fan4tix/IV-25-VFD-Display/images/display1.jpg

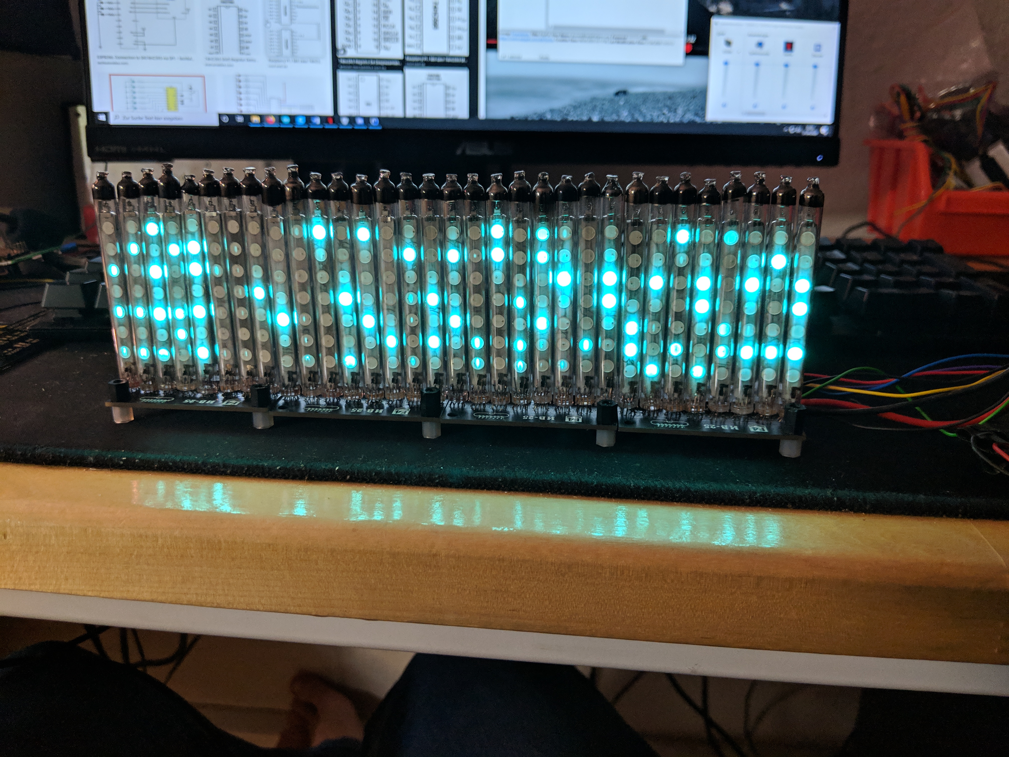
images/display1.jpg
