fan4tix/IV-25-VFD-Display/images/display3.jpg

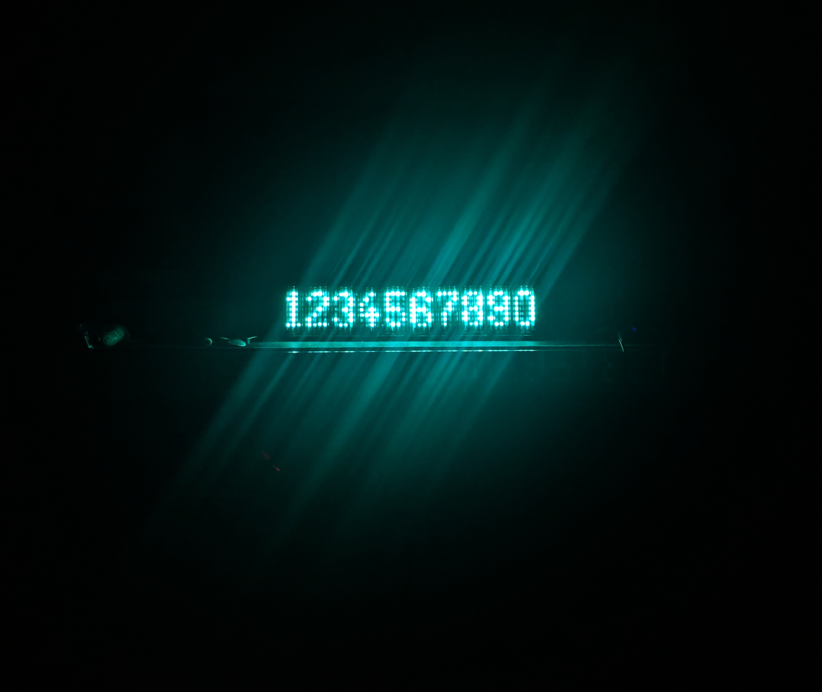
images/display3.jpg
