fan4tix/IV-25-VFD-Display/images/display4.jpg

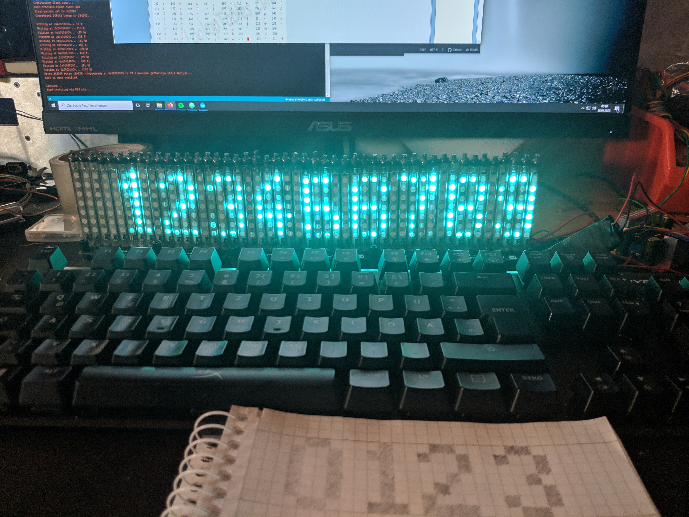
images/display4.jpg
