fan4tix/IV-25-VFD-Display/pcbs/Schematic_IV-25 Controller_2021-01-01.pdf

# GND 15 IO15 16 IO2 17 IO0 18 IO4 19 IO5 20 RXD 21 TXD 22

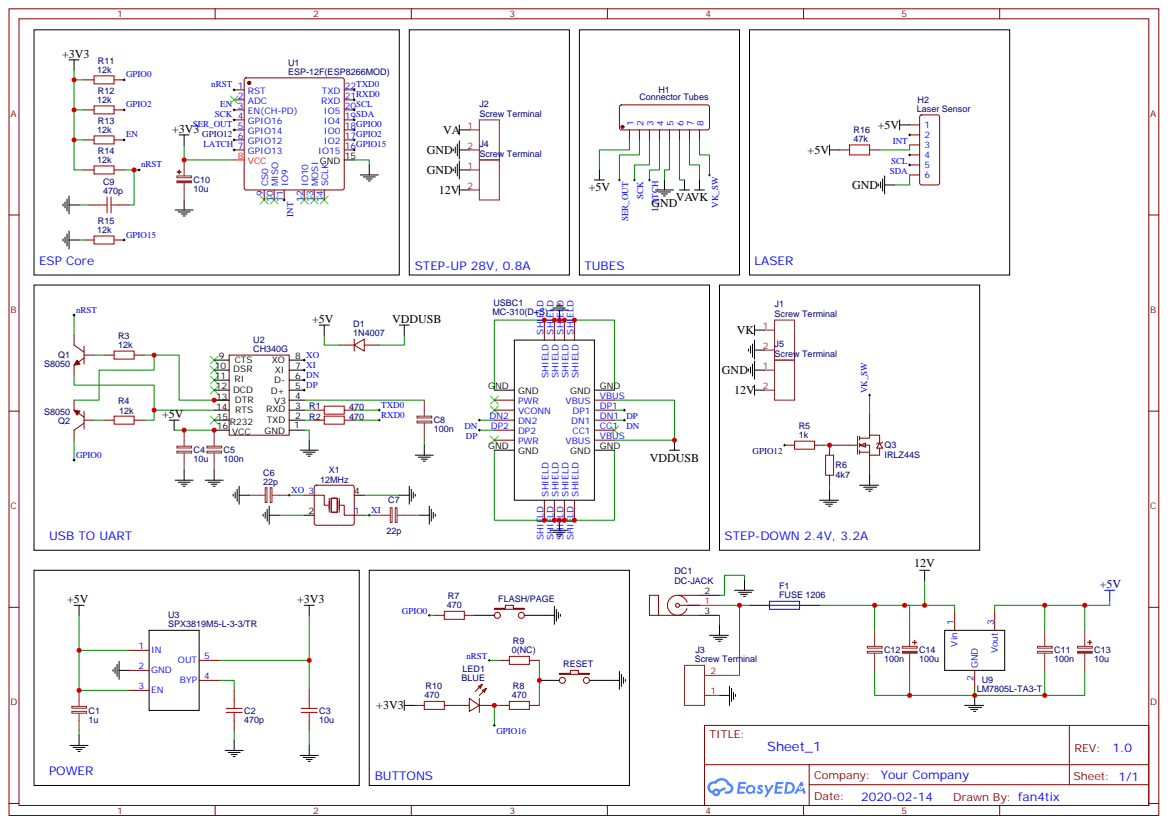
[picture p8: page 1]

SHIELD SHIELD SHIELD SHIELD SHIELD

GND GND VBUS VBUS CC1 CC1 DN1 DN1 DP1 DP1 VBUS VBUS GND GND GND GND
PWR
VCONN
GND
