fan4tix/IV-25-VFD-Display/pcbs/Schematic_IV-25 Dispaly_2021-01-01.pdf

A | A

1

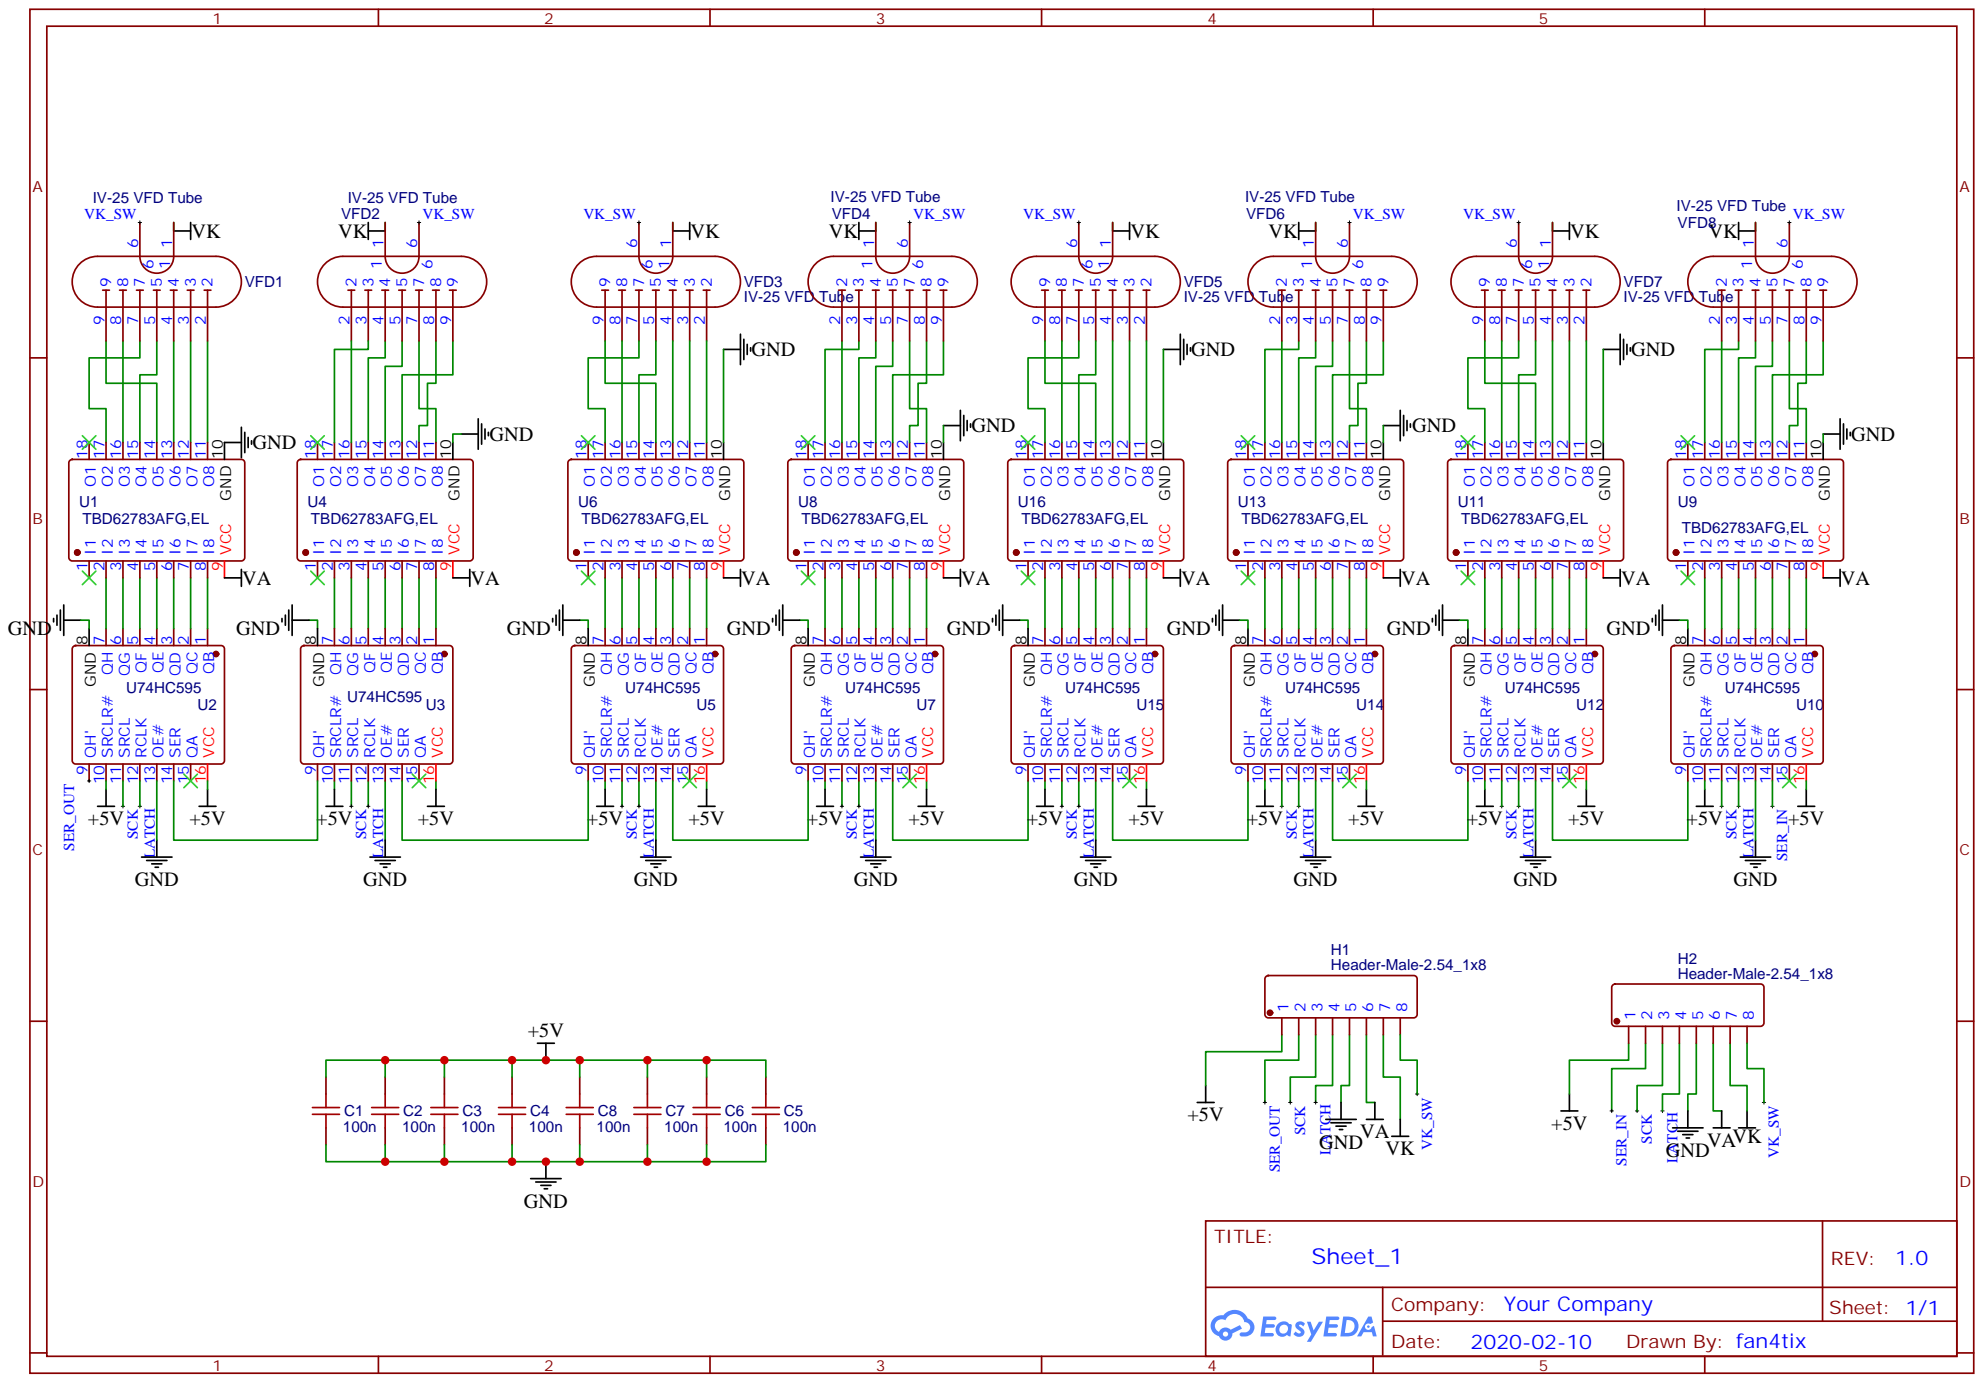
[picture p9: page 1]
