fan4tix/IV-25-VFD-Display/code/IV-25_Display/iv25_font.h

#ifndef _font_h_
#define _font_h_

const uint16_t font_offset[] = {
    0,
    0,
    0,
    0,
    0,
    0,
    0,
    0,
    0,
    0,
    0,
    0,
    0,
    0,
    0,
    0, /* 0 */
    0,
    0,
    0,
    0,
    0,
    0,
    0,
    0,
    0,
    0,
    0,
    0,
    0,
    0,
    0,
    0, /* 1 */
    0,
    2,
    4,
    7,
    0,
    0,
    0,
    13,
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
};
const uint8_t font_data[] = {

    /* ' ' */
    0b00000000,
    0b11111111,

    /* ! */
    0b01111101,
    0b11111111,

    /* " */
    0b01000000,
    0b01000000,
    0b11111111,

    /* # */
    0b00010100,
    0b00111110,
    0b00010100,
    0b00111110,
    0b00010100,
    0b11111111,

    /* ' */
    0b01000000,
    0b11111111,

    /* ( */
    0b01000001,
    0b00111110,
    0b11111111,

    /* ) */
    0b00111110,
    0b01000001,
    0b11111111,

    /* * */
    0b00010100,
    0b00001000,
    0b00010100,
    0b11111111,

    /* + */
    0b00001000,
    0b00011100,
    0b00001000,
    0b11111111,

    /* - */
    0b00001000,
    0b00001000,
    0b00001000,
    0b11111111,

    /* / */
    0b01110000,
    0b00001110,
    0b00000001,
    0b11111111,

    /* 0 */
    0b00111110,
    0b01000001,
    0b01000001,
    0b00111110,
    0b11111111,

    /* 1 */
    0b00000001,
    0b01111111,
    0b00100001,
    0b11111111,

    /* 2 */
    0b00110001,
    0b01001001,
    0b01000101,
    0b00100011,
    0b11111111,

    /* 3 */
    0b00110110,
    0b01001001,
    0b01000001,
    0b00100010,
    0b11111111,

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
    0b00000110,
    0b00001001,
    0b00000110,
    0b11111111,

    /* p */
    0b00001100,
    0b00010010,
    0b00001111,
    0b11111111,

    /* q */
    0b00001111,
    0b00010010,
    0b00001100,
    0b11111111,

    /* r */
    0b00001000,
    0b00000100,
    0b00001111,
    0b11111111,

    /* s */
    0b00010010,
    0b00010101,
    0b00001001,
    0b11111111,

    /* t */
    0b00010001,
    0b00111110,
    0b00010000,
    0b11111111,

    /* u */
    0b00001111,
    0b00000001,
    0b00001110,
    0b11111111,

    /* v */
    0b00001110,
    0b00000001,
    0b00001110,
    0b11111111,

    /* w */
    0b00001110,
    0b00000001,
    0b00000110,
    0b00000001,
    0b00001110,
    0b11111111,

    /* x */
    0b00001001,
    0b00000110,
    0b00001001,
    0b11111111,

    /* y */
    0b00001110,
    0b00000101,
    0b00001001,
    0b11111111,

    /* z */
    0b00001101,
    0b00001011,
    0b00001001,
    0b11111111,
    /*  */
    0b00000000,
    0b00000000,
    0b00000000,
    0b00000000,
    0b11111111,

    /* . */
    0b00000001,
    0b11111111,

};

#endif
