fan4tix/IV-25-VFD-Display/(commit log)

2021-01-02 Changed code to proper Arduino Library, more board testing
2021-01-02 Added Schematics + Gerber files for Rev. 1.0
